LianYangCn/STM8S_FM17550/技术文档/FM17550读卡模块软件概要设计说明书.docx

FM17550读卡模块

软件概要设计说明书

重庆智之屋科技发展

有限公司

变更记录

版本号 | 修改点说明 | 变更日期 | 变更人 | 审批人
V0 | 创建 | 2018-01-24 | 刘健

修改点说明的内容有如下几种：创建、修改（+修改说明）、删除（+删除说明）

# 1 概述

## 1.1 目的

文档编写目的是为了阐述系统的软件设计，文档说明了项目软件各模块概要设计。

## 1.2 适用范围

本说明书的预期读者为系统设计人员、软件开发人员。

# 2 缩写和术语

名称 | 中文解释

# 3设计目标和约束

## 2.1 设计目标

满足《基于FM17550读卡模块需求_接口说明》的要求，软件系统具有良好的可扩展性。

## 2.2设计约束

硬件平台：STM8S003F3PL

开发语言：C语言

开发工具：IAR Embedded Workbench for STMicroelectronics STM8 3.10

编码规范：MISRA-C:2004

# 4软件系统架构

Microcontroller abstraction Layer（微控制器抽象层）：wwdg(看门狗)、rlt(定时器)、gpio(I/O)、uart（串口）、spi（spi）、flash（模拟eeprom）、clk（系统时钟）。

ECU abstraction layer（ECU抽象层）：Mcu_Init（初始化）、UartCmn（串口协议通信）、MemIf（片上/片外存储器操作）、FM17550（FM17550驱动）、TX522B（tx522b协议通信）等。

Complex driver（复杂驱动层）：/

Service layer（服务层）：~~Task（任务片调度）、SlpMng(睡眠管理)~~

Application Layer（应用层）： /

# 5软件模块设计

## 5.1 Mcu_Init模块

### 5.1.1 实现原理

微控制器初始化模块，调用微控制器抽象层接口对微控制器系统时钟、spi接口、uart接口、输入/输出接口等初始化。

### 5.1.2 模块接口说明

### 5.1.3 文件包含关系

### 5.1.4 接口函数描述

函数名称 | void Mcu_init(void)
功能描述 | 初始化
输入 | 无 | 类型 | void
输出 | 无 | 类型 | void
输出 | 无 | 类型 | void

## 5.2 MemIf模块

### 5.2.1 实现原理

片上/片外eeprom操作接口模块，模块根据上层下发的数据对象执行写/读片上或片外eeprom。

### 5.2.2 模块接口说明

### 5.2.3 文件包含关系

### 5.2.4 接口函数描述

函数名称 | uint8 MemIf_WriteEE(uint8 Le_u_Object,uint8* Le_u_Data,uint8 Le_u_Lng)
功能描述 | 写片上/片外eeprom
输入 | Le_u_Object 操作对象（配置项） Le_u_Data 数据 Le_u_Lng 数据长度 | 类型 | uint8 uint8 * uint8
输出 | true 写成功 false 写失败 | 类型 | uint8
函数名称 | uint8 MemIf_ReadEE(uint8 Le_u_Object,uint8* Le_u_Data,uint8 Le_u_Lng)
功能描述 | 读片上/片外eeprom
输入 | Le_u_Object 操作对象（配置项） Le_u_Data 数据 Le_u_Lng 数据长度 | 类型 | uint8 uint8 * uint8
输出 | true 读成功 false 读失败 | 类型 | uint8

## 5.3 UartCmn模块

### 5.3.1 实现原理

模块采用中断驱动式实现串口数据的接收/发送半双工通信，总线数据的收/发只需在串口中断入口程序中调用UartCmn_Rx_Msg和UartCmn_Tx_Msg接口函数即可。

上层模块周期性查询数据接收更新信息，当接收到一帧数据，调用GetUartCmn_u_RxMsg读取经过校验处理后的有效数据；上层模块写数据时，判断总线收/发是否空闲，总线空闲时调用SetUartCmn_TxFrame将发送数据写于发送缓冲区，模块自动启动数据发送并置发送状态为发送忙。

### 5.3.2 模块接口说明

### 5.3.3 文件包含关系

### 5.3.4 接口函数描述

函数名称 | void InitUARTCMN_Parameter(void)
功能描述 | 初始化
输入 | 无 | 类型 | void
输出 | 无 | 类型 | void
函数名称 | void UartCmn_Rx_Msg(void)
功能描述 | 串口数据接收。串口接收中断调用。
输入 | 无 | 类型 | void
输出 | 无 | 类型 | void
函数名称 | void UartCmn_Tx_Msg(void)
功能描述 | 串口数据发送。串口接收中断调用。
输入 | 无 | 类型 | void
输出 | 无 | 类型 | void
函数名称 | void SetUartCmn_TxFrame(const uint8 LaUartCmn_u_TxData[],uint8 LeUartCmn_u_Lng)
功能描述 | 发送数据写于发送帧并启动数据发送

输入 | LaUartCmn_u_TxData[] 发送数据 | 类型 | uint8
| LeUartCmn_u_Lng 数据长度 | | uint8

输出 | 无 | 类型 | void
函数名称 | uint8 GetUartCmn_u_RxMsgRenew(void)
功能描述 | 获取接收数据更新信息

输入 | 无 | 类型 | void

输出 | 返回值：接收数据更新信息 0— 接收数据未更新 1— 接收到新数据 | 类型 | uint8
函数名称 | void GetUartCmn_u_RxMsg(uint8* LeUartCmn_RxData)
功能描述 | 获取接收数据

输入 | LeUartCmn_RxData 接收数据 | 类型 | uint8*

输出 | 无 | 类型 | void
函数名称 | uint8 GetUartCmn_u_TxIdle(void)
功能描述 | 获取发送是否空闲

输入 | 无 | 类型 | void

输出 | 返回值：1--空闲；0--忙 | 类型 | uint8
函数名称 | uint8 GetUartCmn_u_RxIdle(void)
功能描述 | 获取接收是否空闲

输入 | 无 | 类型 | void

输出 | 返回值：1--空闲；0--忙 | 类型 | uint8

## 5.4 FM17550模块

### 5.4.1 实现原理

FM17550驱动，相关代码由FM17550芯片技术支持提供。

### 5.4.2 模块接口说明

/

### 5.4.3 文件包含关系

/

### 5.4.4 接口函数描述

/

## 5.5 TX522B模块

### 5.5.1 实现原理

根据Tx522b协议，实现密钥设置、读/写卡、自动侦测卡片等功能。

[协议参见《mifare卡读写模块UART接口TX522B应用指南（新版协议）_V2.0.pdf》]

### 5.5.2 模块接口说明

### 5.5.3 文件包含关系

### 5.5.4 接口函数描述

函数名称 | void InitTx522b_Parameter(void)
功能描述 | 初始化
输入 | 无 | 类型 | void
输出 | 无 | 类型 | void
函数名称 | void Tx522b_MainFunction(void)
功能描述 | 主任务调度。
输入 | 无 | 类型 | void
输出 | 无 | 类型 | void

# 6底层接口说明

底层使用ST官方固件库STSW-STM8069，有关固件库的使用请参考文档stm8s-a_stdperiph_lib_um.html。

# 7参考文件

序号 | 文件名称
1 | 基于FM17550读卡模块需求_接口说明
2 | FM17550_um.pdf
3 | mifare卡读写模块UART接口TX522B应用指南（新版协议）_V2.0.pdf

# 8附录
