LianYangCn/STM8S_FM17550/技术文档/FM17550_读卡器模块原理图/ZZW-FM17550-CB-001-V0.3(已小批量试产1000)/ZZW-FM17550-CB-001-V0.3主板物料清单.xls

ZZW-FM17550-CB-001-V0.3物料清单
 | 规格 | 标号 | 封装 | 编号 | 数量
1 | 100nF | C1, C4, C6, C50, C51, C62, C63 | 0603 | 201104163 | 7
2 | 22uF | C2, C3, C64 | 0805 | 200226185 | 3
3 | 1uF | C5 | 0603 | 201105163 | 1
4 | 10uF | C7, C9 | 0603 | 201106163 | 2
5 | 10nF | C8, C10 | 0603 | 201103163 | 2
6 | 15pF | C52, C53 | 0603 | 201150163 | 2
7 | 56pF | C54, C61 | 0603 | 201560163 | 2
8 | 180pF | C55, C56 | 0603 | 201181163 | 2
9 | 91pF | C57, C58 | 0603 | 201910163 | 2
10 | 100pF | C59, C60 | 0603 | 201101163 | 2
11 | GREEN | D1 | LED0603 | 300002163 | 1
12 | RED | D2 | LED0603 | 300001163 | 1
15 | 680nH | L50, L51 | 0603 | 300681163 | 2
17 | 0R | R2, R8, R11，R53, R54 | 0603 | 102000163 | 5
19 | 100K | R4, R50 | 0603 | 102104163 | 2
21 | 1K | R7, R17 | 0603 | 102102163 | 2
22 | 10K | R9 | 0603 | 102103163 | 1
23 | 2.7K | R51 | 0603 | 102272163 | 1
24 | 820R | R52 | 0603 | 102821163 | 1
25 | AO3401 | T1 | SOT-23-H | 300340100 | 1
26 | STM8S003F3P6 | U2 | SOP-20 | 600030001 | 1
27 | LM1117-3.3 | U3 | DSO-G3 | 500111701 | 1
28 | FM17550 | U7 | HVQFN32 | 600175500 | 1
29 | 27.12M | Y1 | 3225 | 300271240 | 1
30 | PCB板 |  |  |  | 1
31 | 排线 |  |  |  | 1
