LianYangCn/STM8S_FM17550/技术文档/FM17550读卡模块测试用例.xls

Sheet: 用例封面
FM17550读卡模块测试用例
项目名称 Project Name | FM17550读卡模块 | 项目编号 Project ID | /
测试类型 Test Type | 黑盒测试 | 测试责任人 Test Owner | 刘健
测试用例修订版本记录(Revision Record of Test Case)
Version 版本 | Revision Contents 修订内容 | Data 日期 | Reviser 修订人
V1.0 | 初版 | 2018.1.26 | 刘健

Sheet: 功能用例
编号 | 功能 | 用例编号 | 前置条件 | 用例操作步骤 | 预期结果 | 实测结果 | 结论 | 备注
1 | 激活A卡片 并获取卡号 | 1.0.1 | 1）通过MICRO USB连接模块 和PC机，打开串口调试工 具，设置波特率9600bit/s 2）卡片置于模块天线范围（<4cm）内 | 1）PC串口下发指令： 20 00 21 01 00 DF 03 | PC串口返回值： 20 00 00 xx xx xx xx xx xx xx xx xx xx 03 | PC串口返回值： 20 00 00 xx xx xx xx xx xx xx xx xx xx 03 | ok
 |  | 1.0.2 | 1）通过MICRO USB连接模块 和PC机，打开串口调试工 具，设置波特率9600bit/s 2）卡片置于模块天线范围外 | 1）PC串口下发指令： 20 00 21 01 00 DF 03 | PC串口返回值： 20 00 FF xx xx xx xx xx xx xx xx xx xx 03 | PC串口返回值： 20 00 FF xx xx xx xx xx xx xx xx xx xx 03 | ok
2 | 写A卡块区（0x15） 数据 | 2.0.1 | 1）通过MICRO USB连接模块 和PC机，打开串口调试工 具，设置波特率9600bit/s 2）卡片置于模块天线范围（<4cm）内 | 1）PC串口下发指令： 20 00 23 11 15 11 22 33 44 55 66 77 88 99 00 00 00 00 00 00 AA 63 03 | PC串口返回值： 20 00 00 00 FF 03 | PC串口返回值： 20 00 00 00 FF 03 | ok
 |  | 2.0.2 | 1）通过MICRO USB连接模块 和PC机，打开串口调试工 具，设置波特率9600bit/s 2）卡片置于模块天线范围外 | 1）PC串口下发指令： 20 00 23 11 15 11 22 33 44 55 66 77 88 99 00 00 00 00 00 00 AA 63 03 | PC串口返回值： 20 00 FF 00 FF 03 | PC串口返回值： 20 00 FF 00 00 03 | ok
3 | 读A卡块区(0x15) 数据 | 3.0.1 | 1）通过MICRO USB连接模块 和PC机，打开串口调试工 具，设置波特率9600bit/s 2）卡片置于模块天线范围（<4cm）内 | 1）PC串口下发指令： 20 00 22 01 15 C9 03 | PC串口返回值： 20 00 00 10 11 22 33 44 55 66 77 88 99 00 00 00 00 00 00 AA 54 03 | PC串口返回值： 20 00 00 10 11 22 33 44 55 66 77 88 99 00 00 00 00 00 00 AA 54 03 | ok
 |  | 3.0.2 | 1）通过MICRO USB连接模块 和PC机，打开串口调试工 具，设置波特率9600bit/s 2）卡片置于模块天线范围外 | 1）PC串口下发指令： 20 00 22 01 15 C9 03 | PC串口返回值： 20 00 FF xx xx xx xx xx xx xx xx xx xx xx xx xx xx xx xx xx xx 03 | PC串口返回值： 20 00 FF xx xx xx xx xx xx xx xx xx xx xx xx xx xx xx xx xx xx 03 | ok
4 | 写卡块区（0x14） 数据 | 4.0.1 | 1）通过MICRO USB连接模块 和PC机，打开串口调试工 具，设置波特率9600bit/s 2）卡片置于模块天线范围（<4cm）内 | 1）PC串口下发指令： 20 00 23 11 14 11 22 33 44 55 66 77 88 99 00 00 00 00 00 00 AA 62 03 | PC串口返回值： 20 00 00 00 FF 03 | PC串口返回值： 20 00 00 00 FF 03 | ok
 |  | 4.0.2 | 1）通过MICRO USB连接模块 和PC机，打开串口调试工 具，设置波特率9600bit/s 2）卡片置于模块天线范围外 | 1）PC串口下发指令： 20 00 23 11 14 11 22 33 44 55 66 77 88 99 00 00 00 00 00 00 AA 62 03 | PC串口返回值： 20 00 FF 00 00 03 | PC串口返回值： 20 00 FF 00 00 03 | ok
5 | 读A卡块区(0x14) 数据 | 5.0.1 | 1）通过MICRO USB连接模块 和PC机，打开串口调试工 具，设置波特率9600bit/s 2）卡片置于模块天线范围（<4cm）内 | 1）PC串口下发指令： 20 00 22 01 14 C8 03 | PC串口返回值： 20 00 00 10 11 22 33 44 55 66 77 88 99 00 00 00 00 00 00 AA 54 03 | PC串口返回值： 20 00 00 10 11 22 33 44 55 66 77 88 99 00 00 00 00 00 00 AA 54 03 | ok
 |  | 5.0.2 | 1）通过MICRO USB连接模块 和PC机，打开串口调试工 具，设置波特率9600bit/s 2）卡片置于模块天线范围外 | 1）PC串口下发指令： 20 00 22 01 14 C8 03 | PC串口返回值： 20 00 FF xx xx xx xx xx xx xx xx xx xx xx xx xx xx xx xx xx xx 03 | PC串口返回值： 20 00 FF xx xx xx xx xx xx xx xx xx xx xx xx xx xx xx xx xx xx 03 | ok
6 | 写卡块区（0x16） 数据 | 6.0.1 | 1）通过MICRO USB连接模块 和PC机，打开串口调试工 具，设置波特率9600bit/s 2）卡片置于模块天线范围（<4cm）内 | 1）PC串口下发指令： 20 00 23 11 16 11 22 33 44 55 66 77 88 99 00 00 00 00 00 00 AA 60 03 | PC串口返回值： 20 00 00 00 FF 03 | PC串口返回值： 20 00 00 00 FF 03 | ok
 |  | 6.0.2 | 1）通过MICRO USB连接模块 和PC机，打开串口调试工 具，设置波特率9600bit/s 2）卡片置于模块天线范围外 | 1）PC串口下发指令： 20 00 23 11 16 11 22 33 44 55 66 77 88 99 00 00 00 00 00 00 AA 60 03 | PC串口返回值： 20 00 FF 00 00 03 | PC串口返回值： 20 00 FF 00 00 03 | ok
7 | 读A卡块区(0x16) 数据 | 7.0.1 | 1）通过MICRO USB连接模块 和PC机，打开串口调试工 具，设置波特率9600bit/s 2）卡片置于模块天线范围（<4cm）内 | 1）PC串口下发指令： 20 00 22 01 16 CA 03 | PC串口返回值： 20 00 00 10 11 22 33 44 55 66 77 88 99 00 00 00 00 00 00 AA 54 03 | PC串口返回值： 20 00 00 10 11 22 33 44 55 66 77 88 99 00 00 00 00 00 00 AA 54 03 | ok
 |  | 7.0.2 | 1）通过MICRO USB连接模块 和PC机，打开串口调试工 具，设置波特率9600bit/s 2）卡片置于模块天线范围外 | 1）PC串口下发指令： 20 00 22 01 16 CA 03 | PC串口返回值： 20 00 FF xx xx xx xx xx xx xx xx xx xx xx xx xx xx xx xx xx xx 03 | PC串口返回值： 20 00 FF xx xx xx xx xx xx xx xx xx xx xx xx xx xx xx xx xx xx 03 | ok
8 | 自动寻卡 | 8.0.1 | 1）通过MICRO USB连接模块 和PC机，打开串口调试工 具，设置波特率9600bit/s 2）卡片置于模块天线范围外 | 1）PC串口下发指令： 20 00 25 01 00 DB 03 | PC串口返回值： 20 00 00 00 FF 03 | PC串口返回值： 20 00 00 00 FF 03 | ok
 |  | 8.0.2 | —— | 接用例8.0.1，卡片（A/B卡，测试时使用A卡，卡号FC 6E FB BA）靠近FM17550读卡模块天线范围（<4cm）内 | PC串口返回值： 20 00 00 08 04 00 08 04 FC 6E FB BA 2C 03 | PC串口返回值： 20 00 00 08 04 00 08 04 FC 6E FB BA 2C 03 | ok
 |  | 8.0.3 | —— | 接用例8.0.2，模块断电，重新上电后卡片（A/B卡，测试时使用A卡，卡号FC 6E FB BA）靠近FM17550读卡模块天线范围（<4cm）内 | PC串口返回值： 20 00 00 08 04 00 08 04 FC 6E FB BA 2C 03 | PC串口返回值： 20 00 00 08 04 00 08 04 FC 6E FB BA 2C 03 | ok
 |  | 8.0.4 | 1）通过MICRO USB连接模块 和PC机，打开串口调试工 具，设置波特率9600bit/s 2）卡片置于模块天线范围（<4cm）内 3）设置自动寻卡模式 | PC串口下发装载密钥指令： 20 00 20 06 11 22 33 44 55 66 AE 03 | 1）PC串口返回值： 20 00 00 00 FF 03 2）退出自动寻卡模式 | 1）PC串口返回值： 20 00 00 00 FF 03 2）退出自动寻卡模式 | ok
 |  | 8.0.5 | 1）通过MICRO USB连接模块 和PC机，打开串口调试工 具，设置波特率9600bit/s 2）卡片置于模块天线范围（<4cm）内 3）设置自动寻卡模式 | PC串口下发激活并获取卡号指令： 20 00 21 01 00 DF 03 | 退出自动寻卡模式 | 退出自动寻卡模式 | ok
 |  | 8.0.6 | 1）通过MICRO USB连接模块 和PC机，打开串口调试工 具，设置波特率9600bit/s 2）卡片置于模块天线范围（<4cm）内 3）设置自动寻卡模式 | PC串口下发读块区数据指令： 20 00 22 01 14 C8 03/20 00 22 01 15 C9 03/20 00 22 01 16 CA 03 | 退出自动寻卡模式 | 退出自动寻卡模式 | ok
 |  | 8.0.7 | 1）通过MICRO USB连接模块 和PC机，打开串口调试工 具，设置波特率9600bit/s 2）卡片置于模块天线范围（<4cm）内 3）设置自动寻卡模式 | PC串口下发写块区数据指令： 20 00 23 11 14 xx xx ...xx 03/20 00 23 11 15 xx xx ...xx 03/20 00 23 11 16 xx xx ...xx 03 | 退出自动寻卡模式 | 退出自动寻卡模式 | ok
 |  | 8.0.8 | 1）通过MICRO USB连接模块 和PC机，打开串口调试工 具，设置波特率9600bit/s 2）卡片置于模块天线范围（<4cm）内 3）设置自动寻卡模式 | PC串口下发自动寻卡指令： | 模块工作于自动寻卡模式 | 模块工作于自动寻卡模式 | ok
