LianYangCn/STM8S_FM17550/技术文档/ZZW-FM17550-CB-001-V0.3.pdf

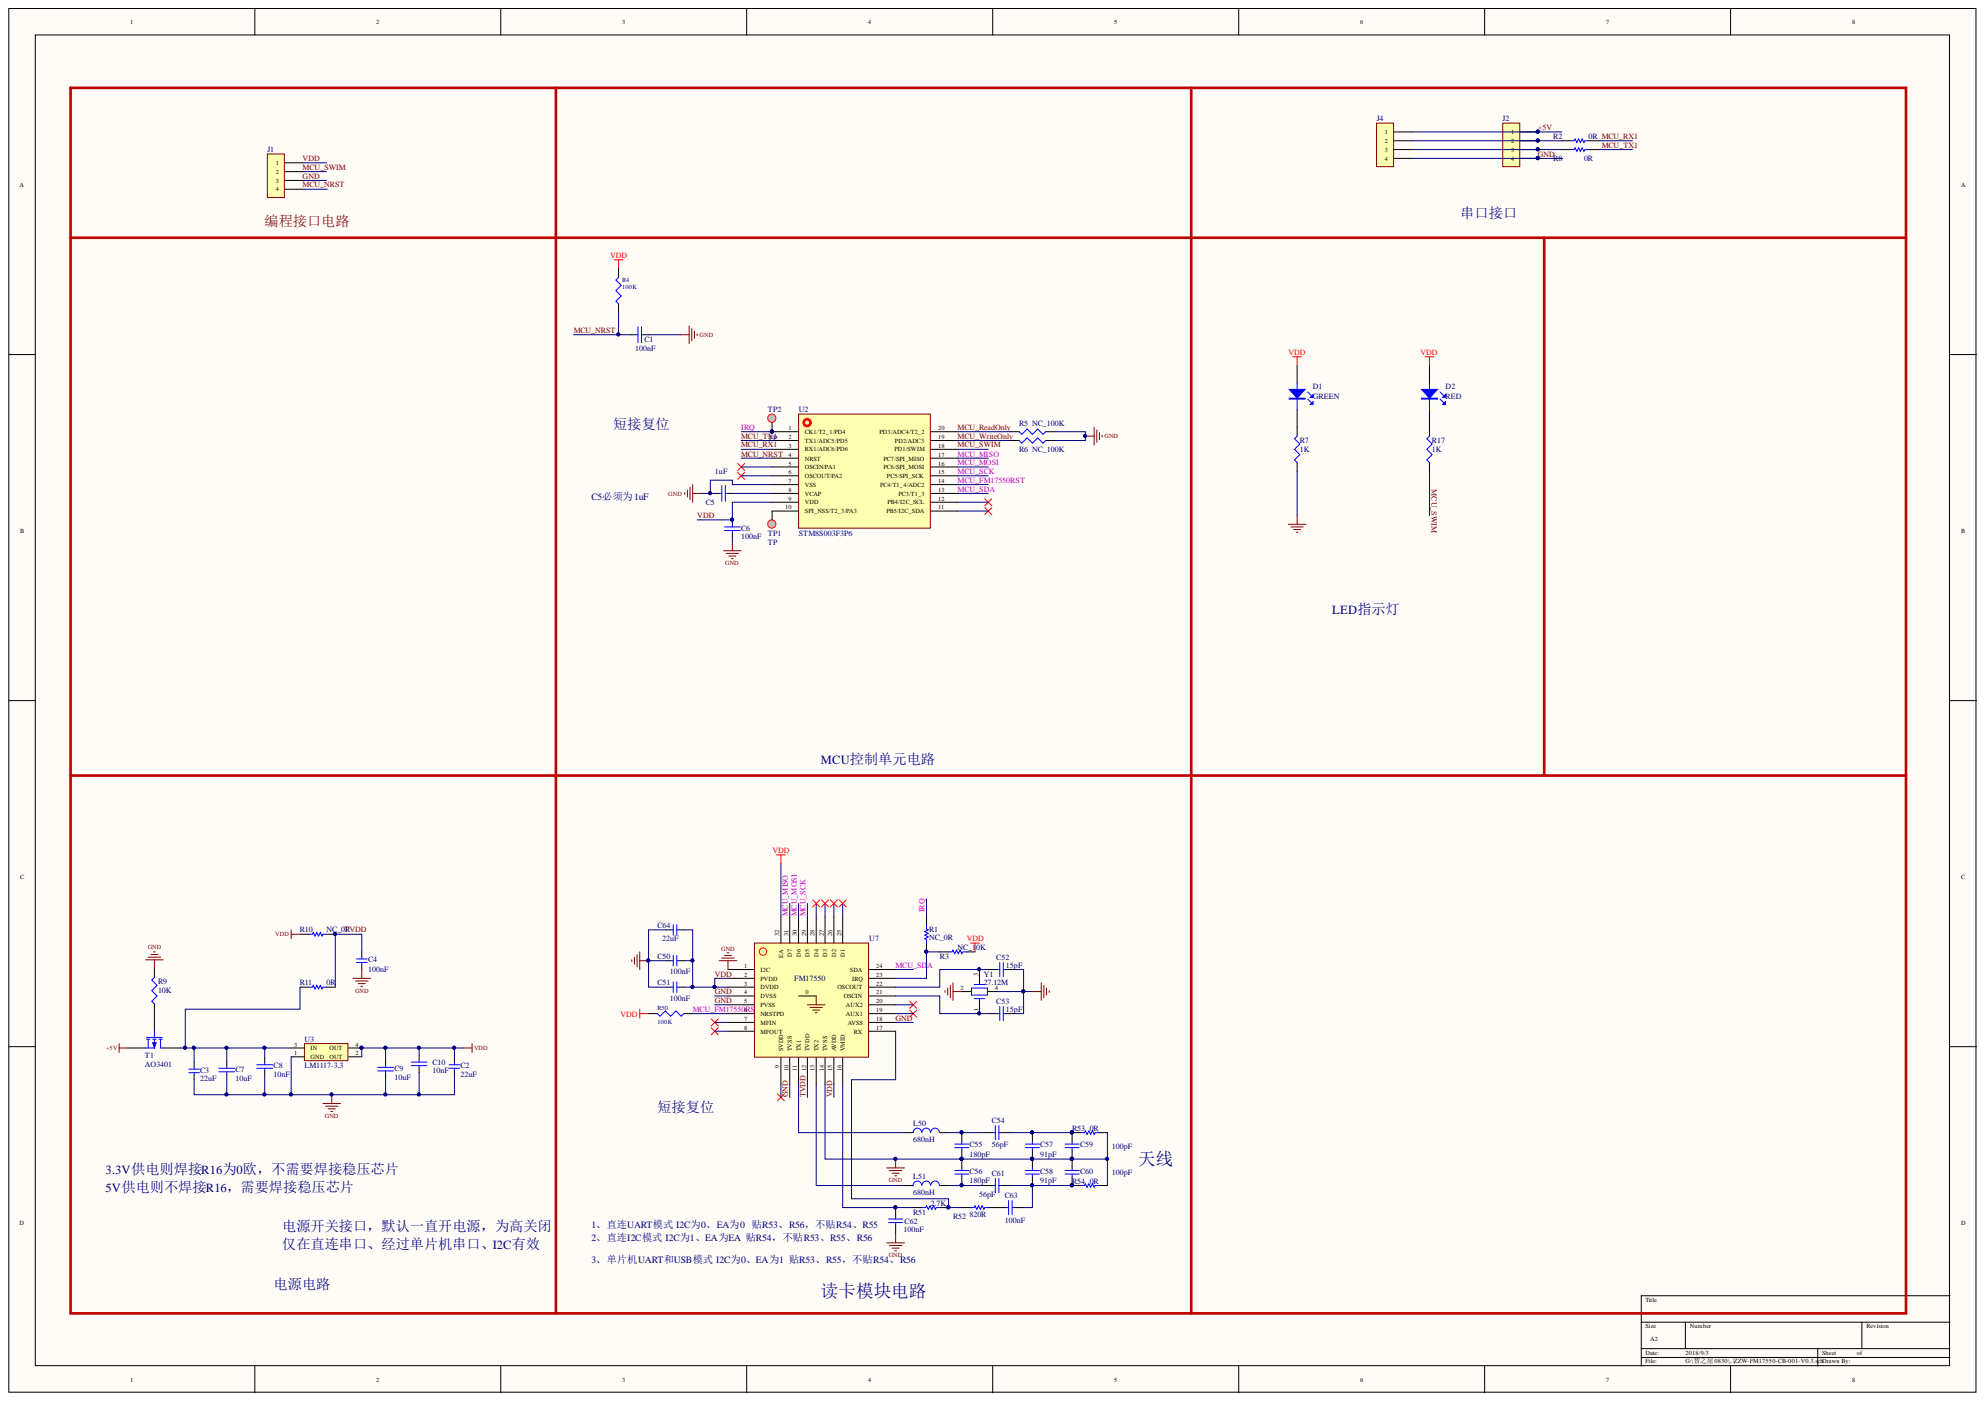
[picture p13: page 1]

GND | C56 100nF
