LianYangCn/STM8S_FM17550/技术文档/FM17550_读卡器模块原理图/ZZW-FM17550-CB-001-V0.1/ZZW-FM17550-CB-001-V0.1 原理图.pdf

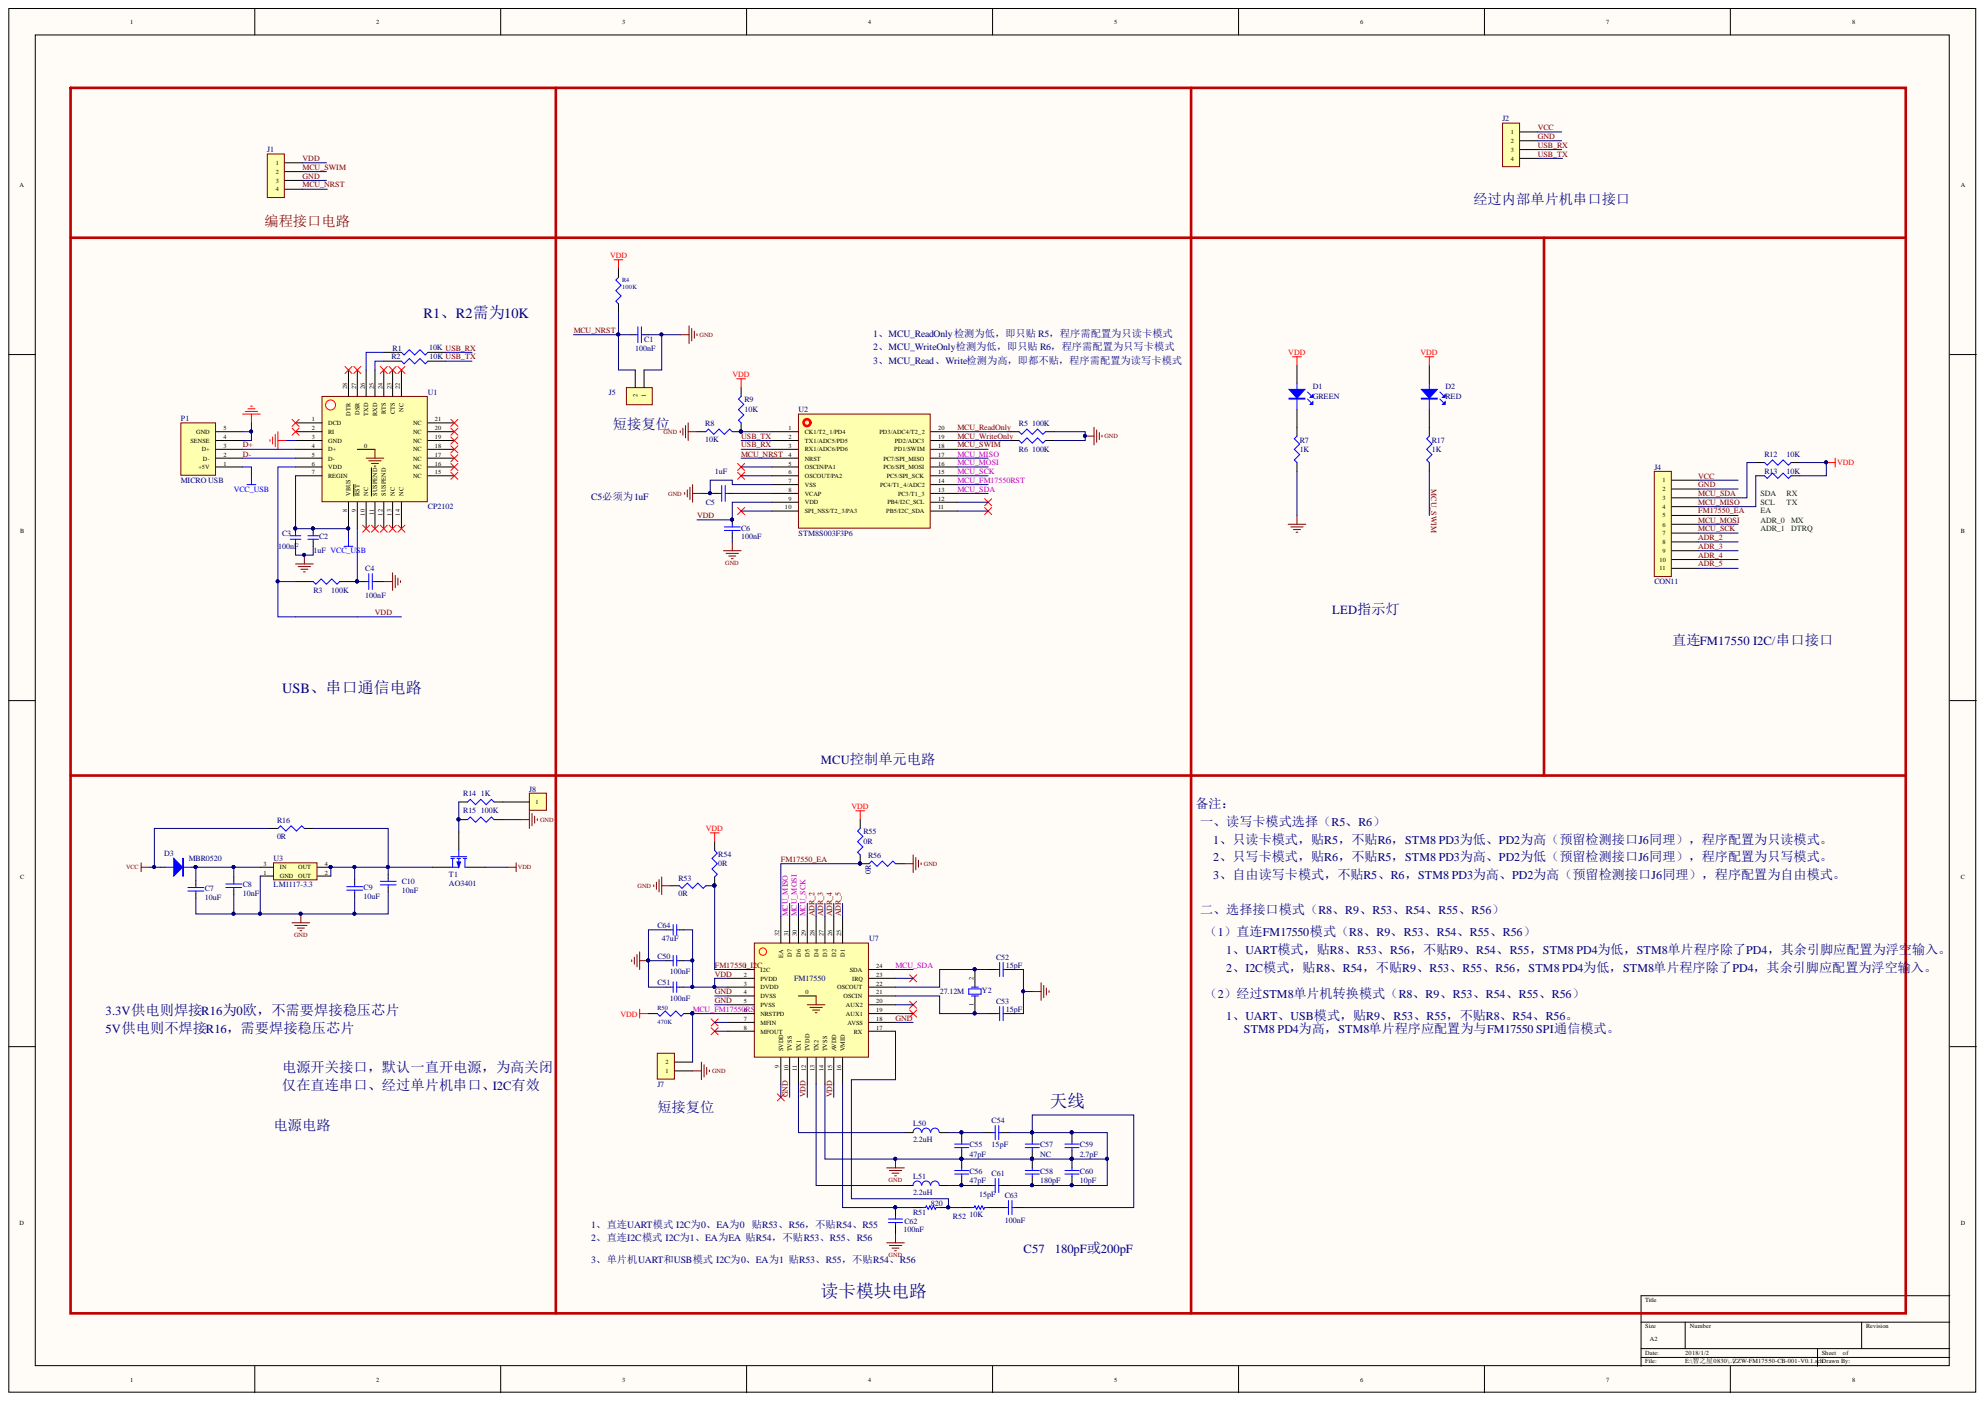
[picture p14: page 1]

NC 22 CTS 23 RTS 24 RXD 25 TXD 26 DSR 27 DTR 28

MFIN 7 | GND

GND | C58 180pF C61 C60 10pF
