LianYangCn/STM8S_FM17550/技术文档/FM17550_读卡器模块原理图/ZZW-FM17550-CB-001-V0.2/ZZW-FM17550-CB-001-V0.2 PCB顶层.pdf

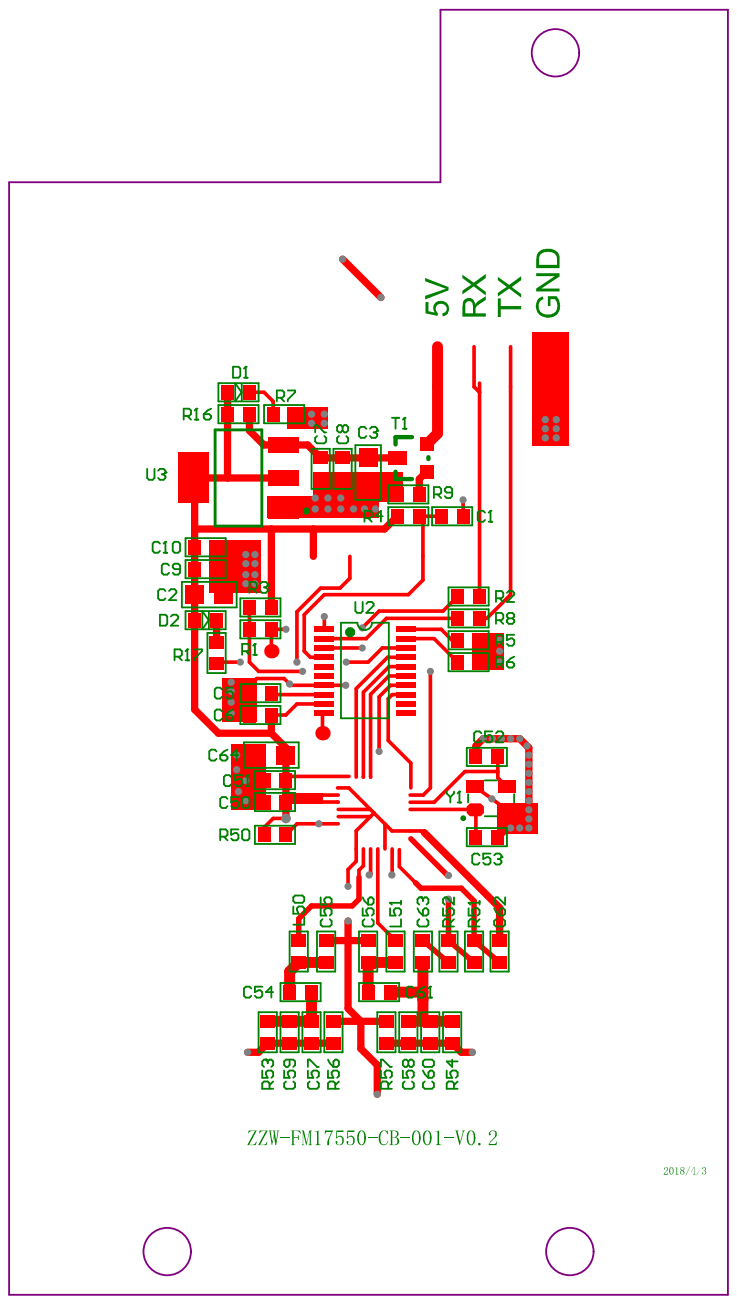
[picture p18: page 1]
