LianYangCn/STM8S_FM17550/CardReader_v1.0/user/FM17550/Middle/type_a.c

/*************************************************************/
//2014.03.06修改版
/*************************************************************/
#include "fm175xx.h"
#include "type_a.h"
#include "Utility.h"
unsigned char  picc_atqa[2],picc_uid[15],picc_sak[3];
//ATQA是只有两个字节，UID却是4个字节加一个BCC校验值所以针对7字节UID防碰撞时就需要最多15字节的UID来存放
//SAK是一个字节的SAK+CRC_A(2字节)
/****************************************************************************************/
/*名称：TypeA_Request																	*/
/*功能：TypeA_Request卡片寻卡															*/
/*输入：																				*/
/*       			    			     												*/
/*	       								 												*/
/*输出：																			 	*/
/*	       	pTagType[0],pTagType[1] =ATQA                                         		*/					
/*       	TRUE: 应答正确                                                              	*/
/*	 		FALSE: 应答错误																*/
/****************************************************************************************/
unsigned char TypeA_Request(unsigned char *pTagType)
{
	unsigned char  result,send_buff[1],rece_buff[2];
	unsigned int  rece_bitlen;  
	Clear_BitMask(TxModeReg,0x80);//关闭TX CRC
	Clear_BitMask(RxModeReg,0x80);//关闭RX CRC
	Set_BitMask(RxModeReg, 0x08);//关闭位接收
	Clear_BitMask(Status2Reg,0x08);
	Write_Reg(BitFramingReg,0x07);
	send_buff[0] = 0x26;
   	Pcd_SetTimer(2);
	Clear_FIFO();
	result = Pcd_Comm(Transceive,send_buff,1,rece_buff,&rece_bitlen);
	if ((result == TRUE) && (rece_bitlen == 2*8))
	{    
		*pTagType     = rece_buff[0];
		*(pTagType+1) = rece_buff[1];
	}
  
	return result;
}
/****************************************************************************************/
/*名称：TypeA_WakeUp																	*/
/*功能：TypeA_WakeUp卡片寻卡															*/
/*输入：																				*/
/*       			    			     												*/
/*	       								 												*/
/*输出：																			 	*/
/*	       	pTagType[0],pTagType[1] =ATQA                                         		*/					
/*       	TRUE: 应答正确                                                              	*/
/*	 		FALSE: 应答错误																*/
/****************************************************************************************/
unsigned char TypeA_WakeUp(unsigned char *pTagType)
{
	unsigned char   result,send_buff[1],rece_buff[2];
	unsigned int   rece_bitlen;  
	Clear_BitMask(TxModeReg,0x80);//关闭TX CRC
	Clear_BitMask(RxModeReg,0x80);//关闭RX CRC
	Set_BitMask(RxModeReg, 0x08);//不接收小于4bit的数据
	Clear_BitMask(Status2Reg,0x08);
	Write_Reg(BitFramingReg,0x07);
 	send_buff[0] = 0x52;
   	Pcd_SetTimer(2);
	Clear_FIFO();
	result = Pcd_Comm(Transceive,send_buff,1,rece_buff,&rece_bitlen);

	if ((result == TRUE) && (rece_bitlen == 2*8))
	{    
		*pTagType     = rece_buff[0];
		*(pTagType+1) = rece_buff[1];
	}
	return result;
}
/****************************************************************************************/
/*名称：TypeA_Anticollision																*/
/*功能：TypeA_Anticollision卡片防冲突													*/
/*输入：selcode =0x93，0x95，0x97														*/
/*       			    			     												*/
/*	       								 												*/
/*输出：																			 	*/
/*	       	pSnr[0],pSnr[1],pSnr[2],pSnr[3]pSnr[4] =UID                            		*/					
/*       	TRUE: 应答正确                                                              	*/
/*	 		FALSE: 应答错误																*/
/****************************************************************************************/
unsigned char TypeA_Anticollision(unsigned char selcode,unsigned char *pSnr)
{
    unsigned char   result,i,send_buff[2],rece_buff[5];
    /*volatile*/ unsigned int   rece_bitlen;
	Clear_BitMask(TxModeReg,0x80);
	Clear_BitMask(RxModeReg,0x80);
    Clear_BitMask(Status2Reg,0x08);
    Write_Reg(BitFramingReg,0x00);
    Clear_BitMask(CollReg,0x80);
 
    send_buff[0] = selcode;
    send_buff[1] = 0x20;             //NVB
    Pcd_SetTimer(2);
	Clear_FIFO();
    result = Pcd_Comm(Transceive,send_buff,2,rece_buff,&rece_bitlen);

    if (result == TRUE)
    {
    	for (i=0; i<5; i++)
        {   
            *(pSnr+i)  = rece_buff[i];
        }
        if (pSnr[4] != (pSnr[0]^pSnr[1]^pSnr[2]^pSnr[3]))     //UID0、UID1、UID2、UID3、BCC(校验字节)
    	result = FALSE;    
    }
  return result;
}
/****************************************************************************************/
/*名称：TypeA_Select																	*/
/*功能：TypeA_Select卡片选卡															*/
/*输入：selcode =0x93，0x95，0x97														*/
/*      pSnr[0],pSnr[1],pSnr[2],pSnr[3]pSnr[4] =UID 			    			     	*/
/*	       								 												*/
/*输出：																			 	*/
/*	       	pSak[0],pSak[1],pSak[2] =SAK			                            		*/					
/*       	TRUE: 应答正确                                                              	*/
/*	 		FALSE: 应答错误																*/
/****************************************************************************************/
unsigned char TypeA_Select(unsigned char selcode,unsigned char *pSnr,unsigned char *pSak)
{
    unsigned char   result,i,send_buff[7],rece_buff[5];
    unsigned int   rece_bitlen;
	Write_Reg(BitFramingReg,0x00);
  	Set_BitMask(TxModeReg,0x80);      //打开TX CRC
	Set_BitMask(RxModeReg,0x80);        //打开接收RX 的CRC校验
    Clear_BitMask(Status2Reg,0x08);
	
	send_buff[0] = selcode;        //SEL
    send_buff[1] = 0x70;         //NVB
    
    for (i=0; i<5; i++)
    {
    	send_buff[i+2] = *(pSnr+i);
    }
   	
	Pcd_SetTimer(2);
	Clear_FIFO();
    result = Pcd_Comm(Transceive,send_buff,7,rece_buff,&rece_bitlen);
    
    if (result == TRUE)
	{ 
		*pSak=rece_buff[0]; 
	}
    return result;
}
/****************************************************************************************/
/*名称：TypeA_Halt																		*/
/*功能：TypeA_Halt卡片停止																*/
/*输入：																				*/
/*       			    			     												*/
/*	       								 												*/
/*输出：																			 	*/
/*	       											                            		*/					
/*       	TRUE: 应答正确                                                              	*/
/*	 		FALSE: 应答错误																*/
/****************************************************************************************/
unsigned char TypeA_Halt(void)
{
    unsigned char   result,send_buff[2],rece_buff[1];
	unsigned int   rece_bitlen;
    send_buff[0] = 0x50;
    send_buff[1] = 0x00;
   
   	Write_Reg(BitFramingReg,0x00);
  	Set_BitMask(TxModeReg,0x80);
	Set_BitMask(RxModeReg,0x80);
    Clear_BitMask(Status2Reg,0x08);
	Pcd_SetTimer(2);
	Clear_FIFO();
    result = Pcd_Comm(Transmit,send_buff,2,rece_buff,&rece_bitlen);
    return result;
}
/****************************************************************************************/
/*名称：TypeA_CardActive																*/
/*功能：TypeA_CardActive卡片激活														*/
/*输入：																				*/
/*       			    			     												*/
/*	       								 												*/
/*输出：	pTagType[0],pTagType[1] =ATQA 											 	*/
/*	       	pSnr[0],pSnr[1],pSnr[2],pSnr[3]pSnr[4] =UID 		                   		*/
/*	       	pSak[0],pSak[1],pSak[2] =SAK			                            		*/					
/*       	TRUE: 应答正确                                                              	*/
/*	 		FALSE: 应答错误																*/
/****************************************************************************************/
unsigned char TypeA_CardActive(unsigned char *pTagType,unsigned char *pSnr,unsigned char *pLng,unsigned char *pSak)
{
	unsigned char   result;
	unsigned char   Le_u_i;	
	//Pcd_ConfigISOType(0);
	//Set_Rf(3);   //turn on radio
	result=TypeA_Request(pTagType);//寻卡 Standard	 send request command Standard mode
	
	if (result==FALSE)
	{
		return FALSE;
	}
	if 	(((pTagType[0]&0xC0)==0x00) || ((pTagType[0]&0xC0)==0x40) || ((pTagType[0]&0xC0)==0x80))        
	{//M1卡,ID号只有4位					//ID号有7位						//ID号有10位
		result=TypeA_Anticollision(0x93,pSnr);
		if (result==FALSE)
		{
			return FALSE;
		}
		result=TypeA_Select(0x93,pSnr,pSak);
		if (result==FALSE)
		{
			return FALSE;
		}	
		if 	(((pTagType[0]&0xC0)==0x40) || ((pTagType[0]&0xC0)==0x80))    
		{//ID号有7位						//ID号有10位
			for(Le_u_i = 0U;Le_u_i < 3U;Le_u_i++) 
				pSnr[Le_u_i] = pSnr[Le_u_i+1U];
			result=TypeA_Anticollision(0x95,pSnr+3);
			if (result==FALSE)
			{
				return FALSE;
			}
			result=TypeA_Select(0x95,pSnr+3,pSak+1);
			if (result==FALSE)
			{
				return FALSE;
			}
			if 	((pTagType[0]&0xC0)==0x80)       
			{//ID号有10位
				result=TypeA_Anticollision(0x97,pSnr+6);
				if (result==FALSE)
				{
					return FALSE;
				}
				result=TypeA_Select(0x97,pSnr+6,pSak+2);
				if (result==FALSE)
				{
					return FALSE;
				}
				*pLng = 10U;
			}
			else
			{
				*pLng = 7U;
			}
		}
		else
		{
			*pLng = 4U;
		}
	}
	return result;
}
