LianYangCn/STM8S_FM17550/CardReader_v1.0/user/Mcu_Init/Mcu_Init.h

/******************************************************
文件名：	Mcu_Init.h

描述�

Data			  Vasion			author
2018/1/4		  V1.0			    liujian
*******************************************************/
#ifndef		MCU_INIT_H
#define		MCU_INIT_H
/*******************************************************
description：include the header file
*******************************************************/
#include "Include.h"

/*******************************************************
description：macro definitions
*******************************************************/
/**********宏开关定�*******/


/**********宏常量定�*******/



/***********宏函�*********/

/*******************************************************
description：struct definitions
*******************************************************/

/*******************************************************
description：typedef definitions
*******************************************************/
/*****struct definitions*****/

/******enum definitions******/

/******union definitions*****/

/*******************************************************
description：variable External declaration
*******************************************************/

/*******************************************************
description：function External declaration
*******************************************************/
extern void Mcu_Init(void);
extern void Mcu_Init_SetBaudRtae(uint32_t BaudRate);
#endif
