LianYangCn/STM8S_FM17550/CardReader_v1.0/user/FM17550/Middle/mifare_card.h

extern unsigned char Mifare_Transfer(unsigned char block);
extern unsigned char Mifare_Restore(unsigned char block);
extern unsigned char Mifare_Blockset(unsigned char block,unsigned char *buff);
extern unsigned char Mifare_Blockinc(unsigned char block,unsigned char *buff);
extern unsigned char Mifare_Blockdec(unsigned char block,unsigned char *buff);
extern unsigned char Mifare_Blockwrite(unsigned char block,unsigned char *buff);
extern unsigned char Mifare_Blockread(unsigned char block,unsigned char *buff);
extern unsigned char Mifare_Auth(unsigned char mode,unsigned char sector,unsigned char *mifare_key,unsigned char *card_uid,unsigned char card_uidLng);
