LianYangCn/STM8S_FM17550/CardReader_v1.0/user/Include.h

/******************************************************
文件名：	Mcu_Init.h

描述�

Data			  Vasion			author
2018/1/4		  V1.0			    liujian
*******************************************************/
#ifndef		INCLUDE_H
#define		INCLUDE_H
/*******************************************************
description：include the header file
*******************************************************/
#include "fm175xx.h"
#include "type_a.h"
#include "type_b.h"
#include "Utility.h"
#include "mifare_card.h"
#include "stm8s_uart1.h"
#include "stm8s_clk.h"
//#include "string.h"
#include "CardRd.h"
#include "stm8s.h"
#include "stm8s_spi.h"
#include "stm8s_gpio.h"
#include "Mcu_Init.h"
#include "MyType.h"
#include "UartCmn.h"
#include "stm8s_it.h"
#include "Tx522b.h"
#include "stm8s_flash.h"
#include "MemIf.h"
/*******************************************************
description：macro definitions
*******************************************************/


/*******************************************************
description��Often use of macro definitions
*******************************************************/









/*******************************************************
description：struct definitions
*******************************************************/

/*******************************************************
description：typedef definitions
*******************************************************/
/*****struct definitions*****/

/******enum definitions******/

/******union definitions*****/

/*******************************************************
description：variable External declaration
*******************************************************/

/*******************************************************
description：function External declaration
*******************************************************/

#endif
