LianYangCn/STM8S_FM17550/CardReader_v1.0/user/FM17550/Middle/Utility.c

// ======================================================================================================
//  Copyright (c) 2011 Guangzhou Zhiyuan Electronics Co., Ltd. All rights reserved. 
//  http://www.zlg.cn
//! @file       Utility.c
//! @author     HanYuanQiang
//! @date       2013.01.07
//! @version    V1.01
//! @brief      公共函数
//!                 - V1.01 2012.01.07  韩远强  增加计算字节异或取反校验函数
//!					- V1.00 2012.04.17	曾本森 创建文档
// ======================================================================================================
//#define UTILITY_GLOBALS
#include "Utility.h"

// ======================================================================================================
//! @brief			计算字节累加和
//! @param[in]		*p		-- 计算的数据
//! @param[in]		nBytes	-- 字节数
//! @return			字节累加和
// ======================================================================================================
uint32_t GetByteSum(const void *p, uint32_t nBytes)
{
	const uint8_t	*pBuf	= (const uint8_t *)p;
	uint32_t		sum		= 0;

	while (nBytes--)
	{
		sum += *pBuf++;
	}
	return sum;
}

// ======================================================================================================
//! @brief          计算字节异或取反
//! @param[in]      *p      -- 计算的数据
//! @param[in]      nBytes  -- 字节数
//! @return         字节异或取反
// ======================================================================================================
uint8_t GetByteBCC(const void *p, uint32_t nBytes)
{
    const uint8_t *pBuf = (const uint8_t *)p;
    uint8_t		BCC = 0;
    uint32_t	i   = 0;

    for (i = 0; i < nBytes; i++)
	{
        BCC ^= *(pBuf + i);
    }
    return ~BCC;
}

// ======================================================================================================
//! @brief			延迟（100us为单位）
//! @param[in]		_100us		-- 延迟时间
//! @note			基于LPC1114,48MHz
// ======================================================================================================
void Delay100us(uint32_t _100us)
{
	uint32_t i;
	for ( ; 0 != _100us; _100us--)
	{
		for(i = 0; i < 440; i++);
	}
}
