LianYangCn/STM8S_FM17550/(commit log)

2018-12-05 添加技术文档
    [FM17550读卡模块测试用例.xls, ZZW-FM17550-CB-001-V0.1.sch, ZZW-FM17550-CB-001-V0.2.sch, ZZW-FM17550-CB-001-V0.3.sch, ZZW-FM17550-CB-001-V0.3主板物料清单.xls, ZZW-FM17550-CB-001-V0.4.sch, ZZW-FM17550-CB-001-V0.4主板物料清单.xls]
2018-12-05 编译器产生的文件变化
2018-12-10 优化Mcu_Init模块：优化不使用的GPIO引脚
2018-12-10 优化Tx522b模块：增加卡号长度溢出处理
2018-12-18 修改fm175xx驱动：增加延时时间
2018-12-18 修改tx522b模块：增加非法指令错误状态码
2018-12-18 修改UartCmn.c模块：修复接收数据帧数据部分长度为0时，校验出错问题
2018-12-18 增加0 command 0x52
2018-12-19 修改Tx522b模块：检测到睡眠时，退出睡眠模式；检测到卡号时，软复位读卡芯片
2018-12-19 修改Tx522b模块：A卡和B卡寻卡任务交叉进行，寻卡前先复位读卡芯片
2018-12-20 修改Tx522b模块：缩短自动寻卡自恢复时间
2018-12-24 编译器生成的文件发生变化
2019-01-02 增加硬件复位接口，上电/重启或发送config 指令进行硬件复位
2019-01-10 修改模块操作说明文档
